eleqian/eLight/doc/867A/SCH.png

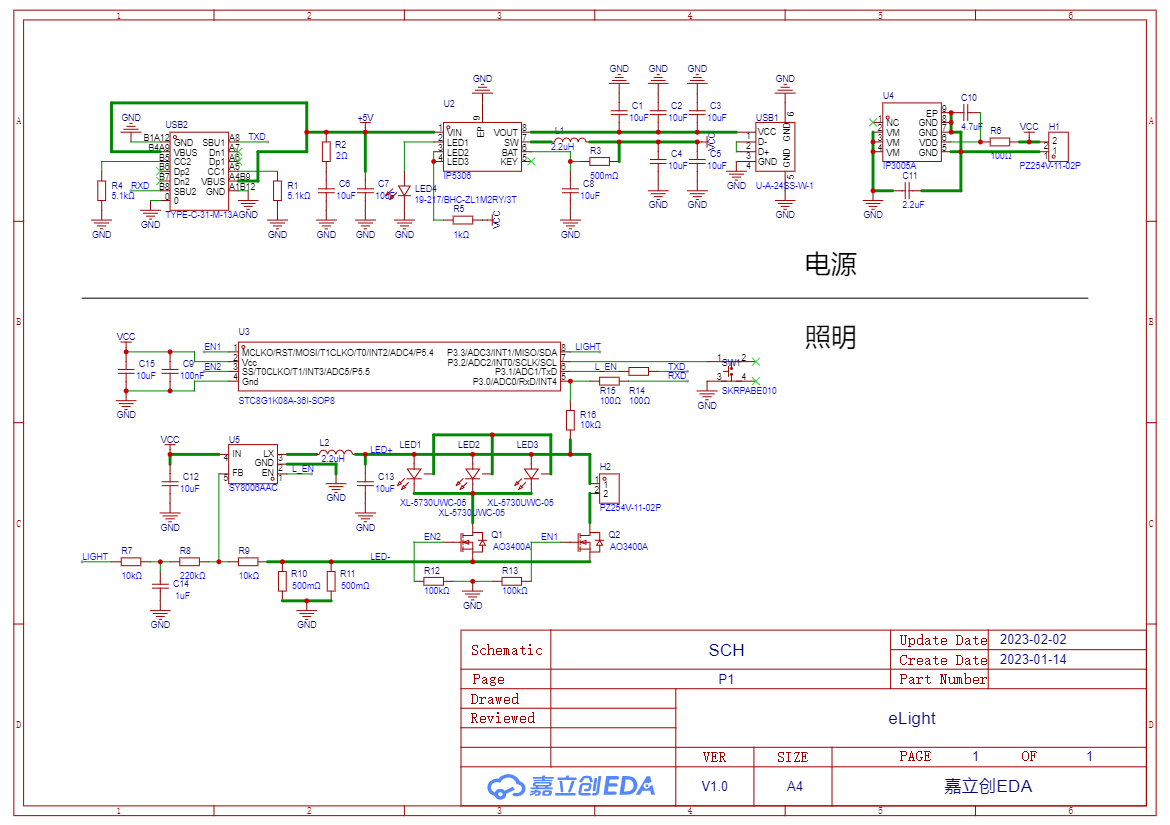
doc/867A/SCH.png
