eleqian/eLight/doc/Core/3D_PCB.png

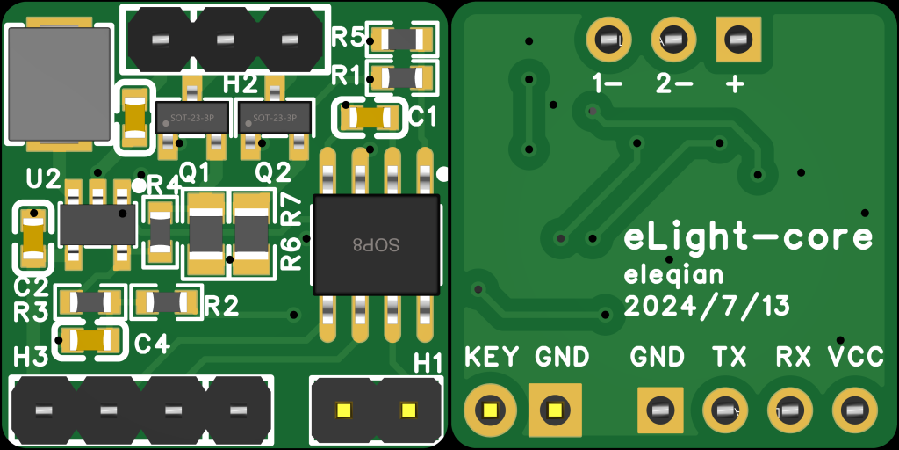
doc/Core/3D_PCB.png
