eleqian/eLight/doc/Core/3D_PCB_B.png

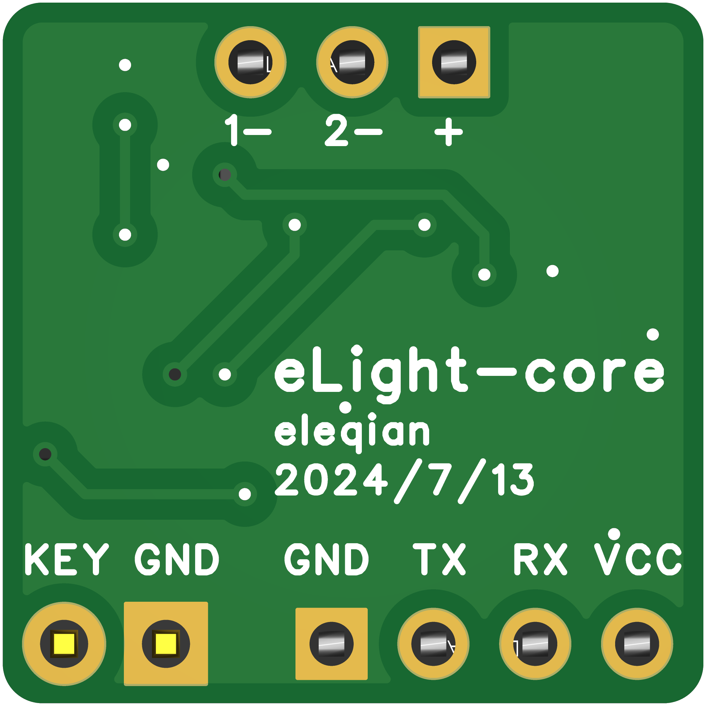
doc/Core/3D_PCB_B.png
