eleqian/eLight/doc/Core/3D_PCB_F.png

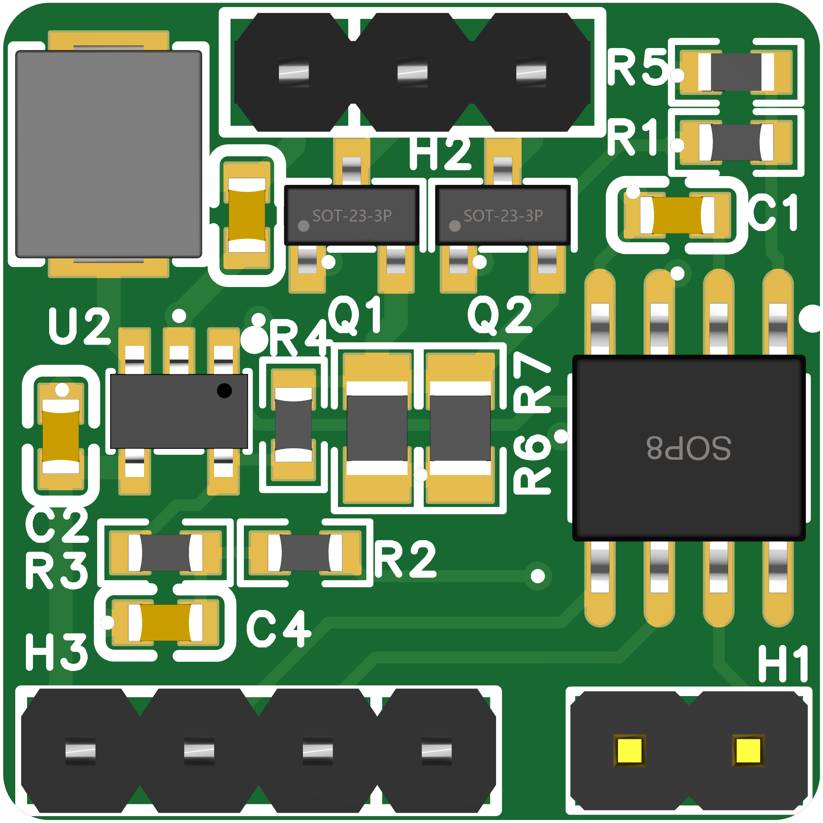
doc/Core/3D_PCB_F.png
