eleqian/eLight/doc/SD-1006/SCH.png

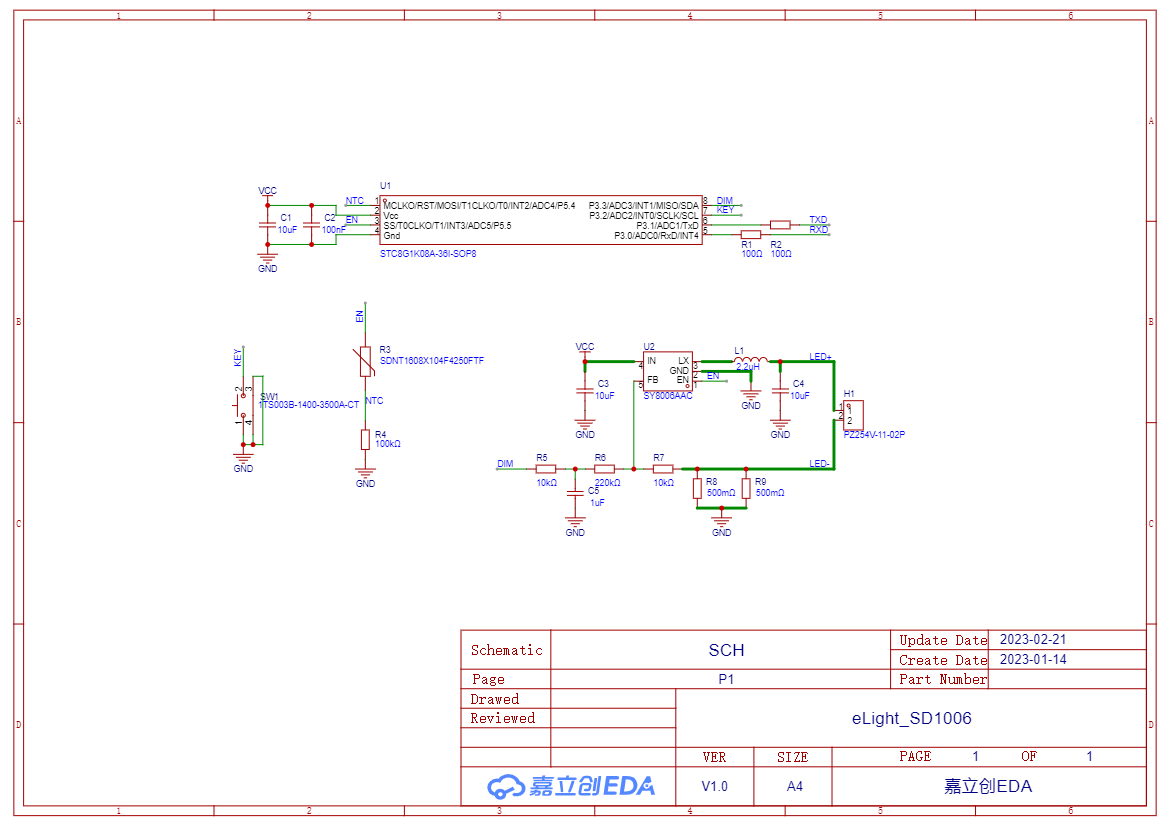
doc/SD-1006/SCH.png
