eleqian/eLight/doc/Core/eLight_Core_PCB.pdf

C1

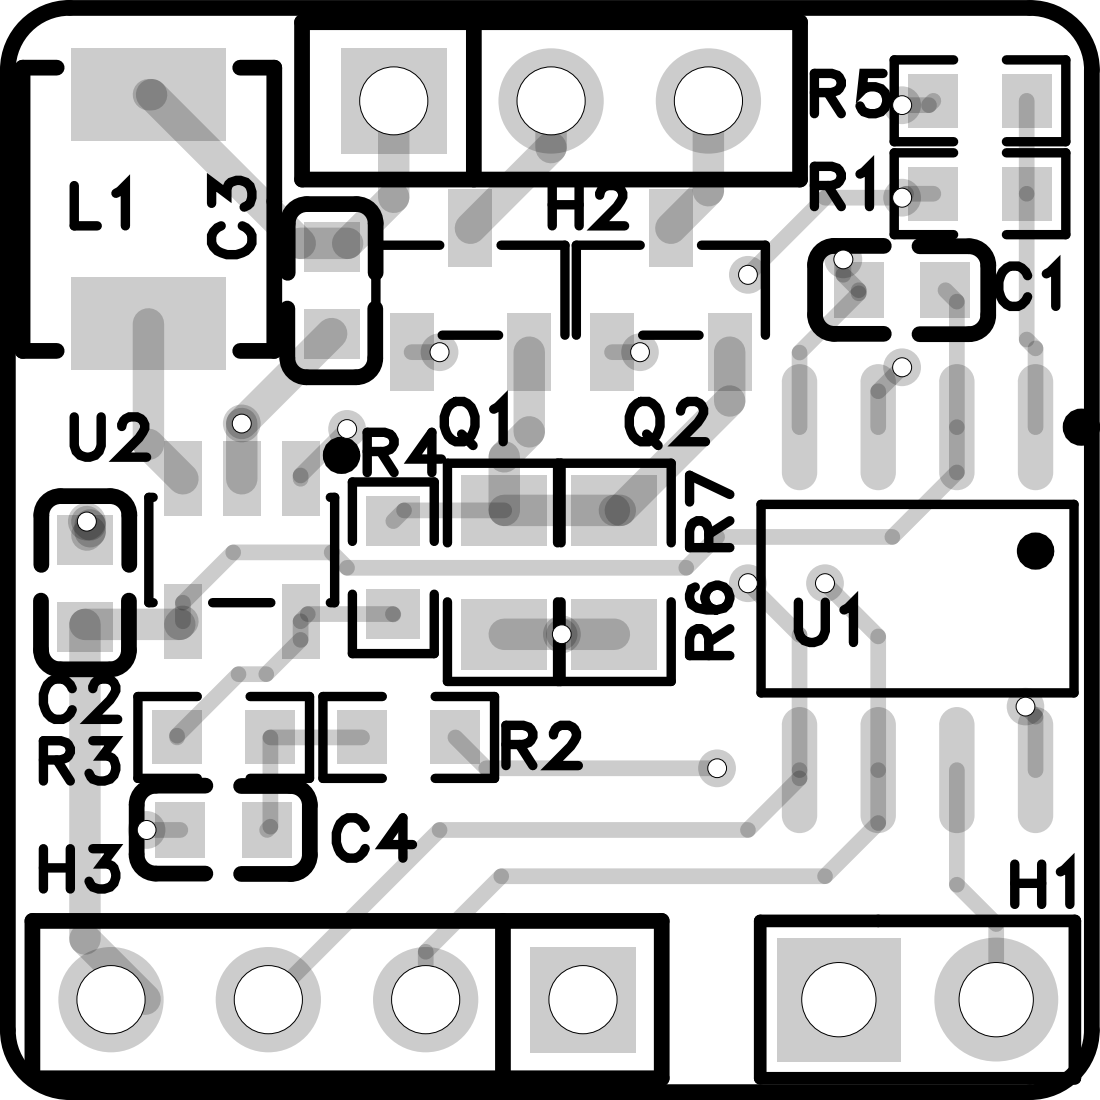
[picture p12: page 1]

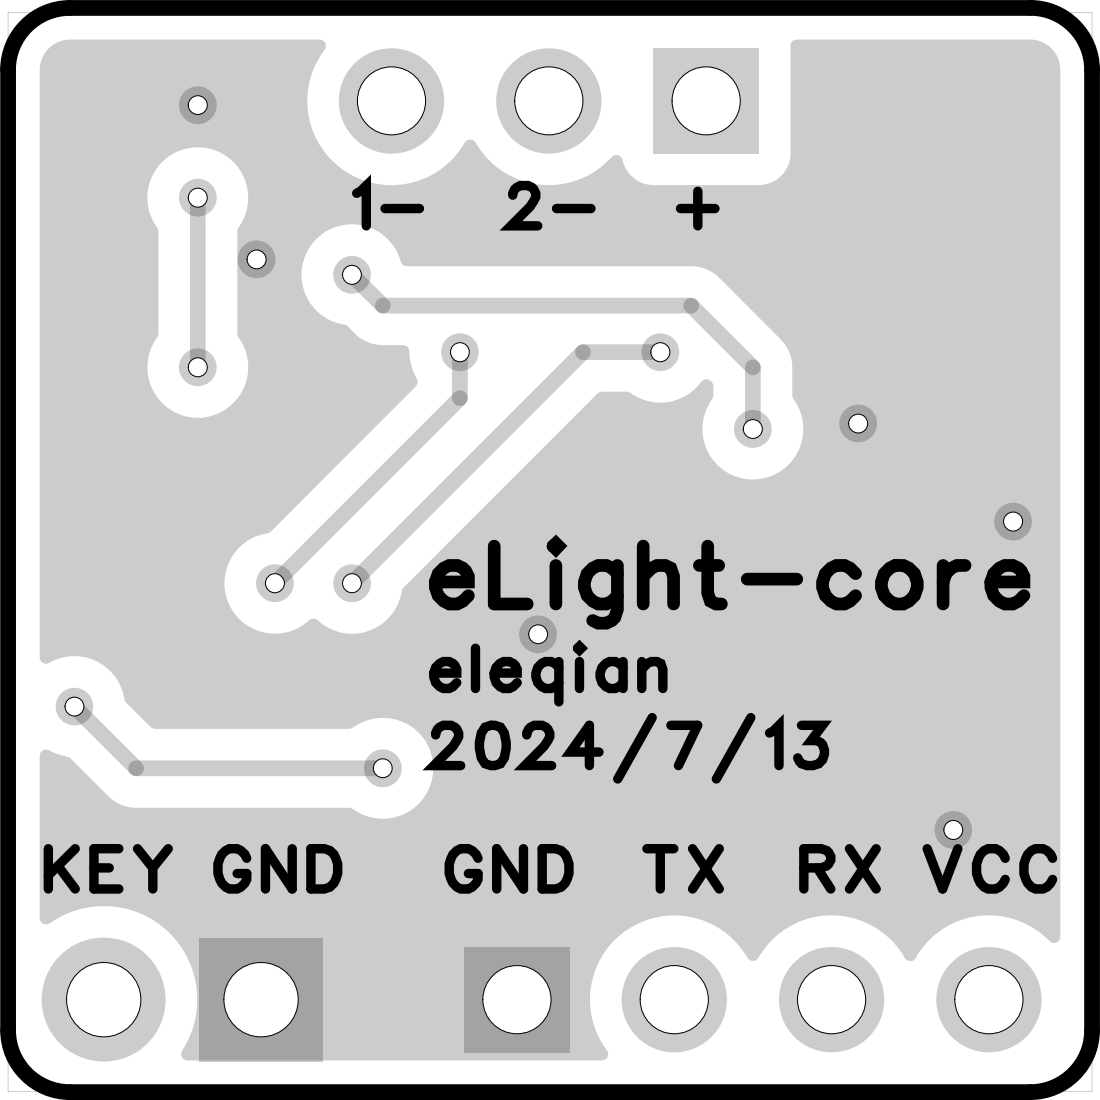
[picture p13: page 2]

KEY GND GND TX RX VCC

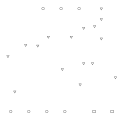
[picture p14: figure]
