eleqian/eLight/doc/Core_1W/eLight_Core_1W_SCH.pdf

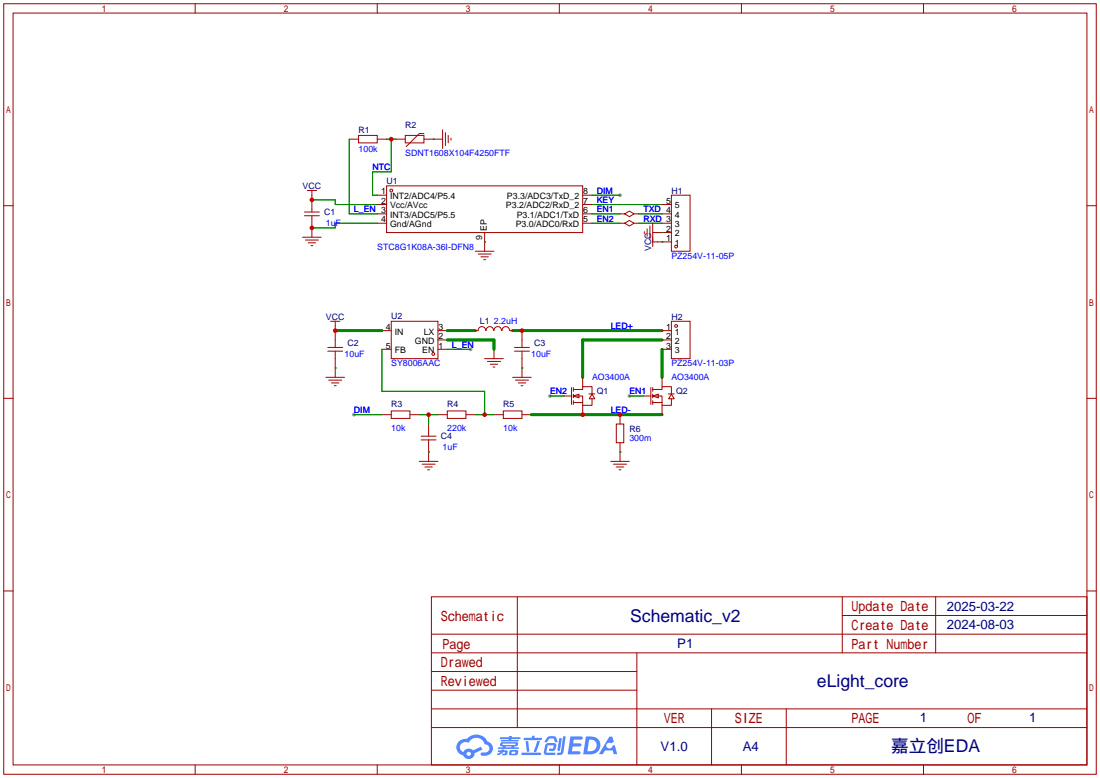
[picture p15: page 1]
