eleqian/eLight/doc/Core_5W/eLight_Core_5W_SCH.pdf

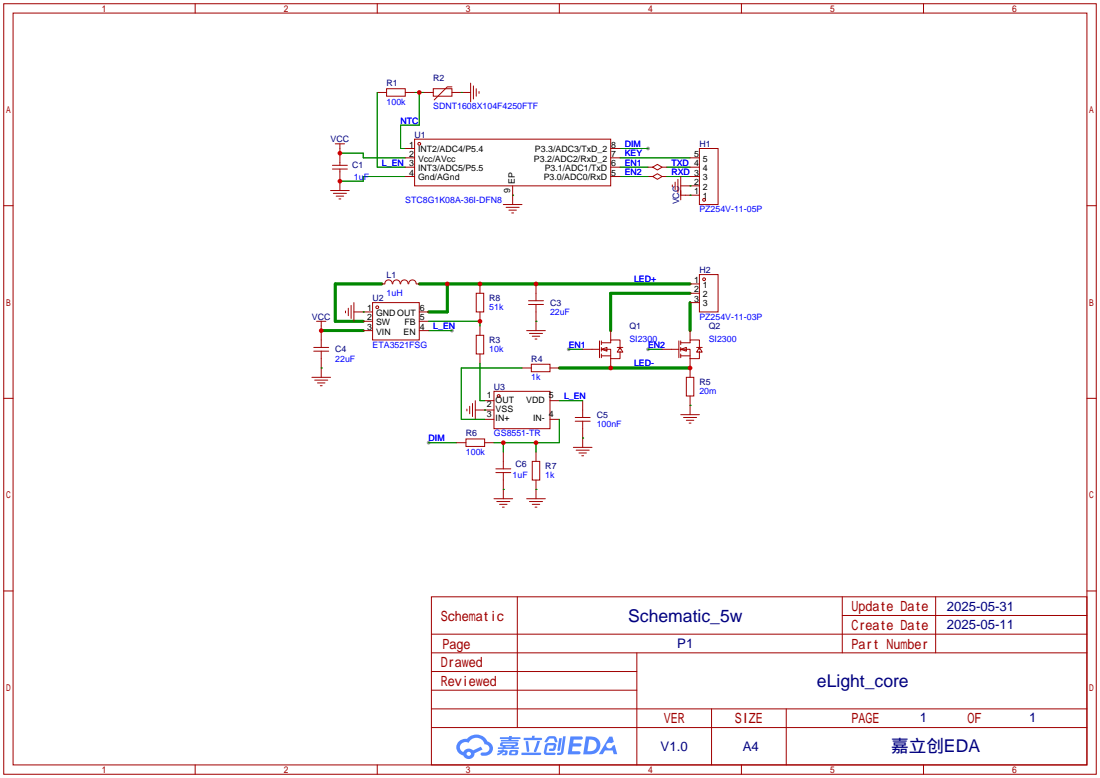
[picture p16: page 1]
