eleqian/eLight/doc/Core/eLight_Core_SCH.pdf

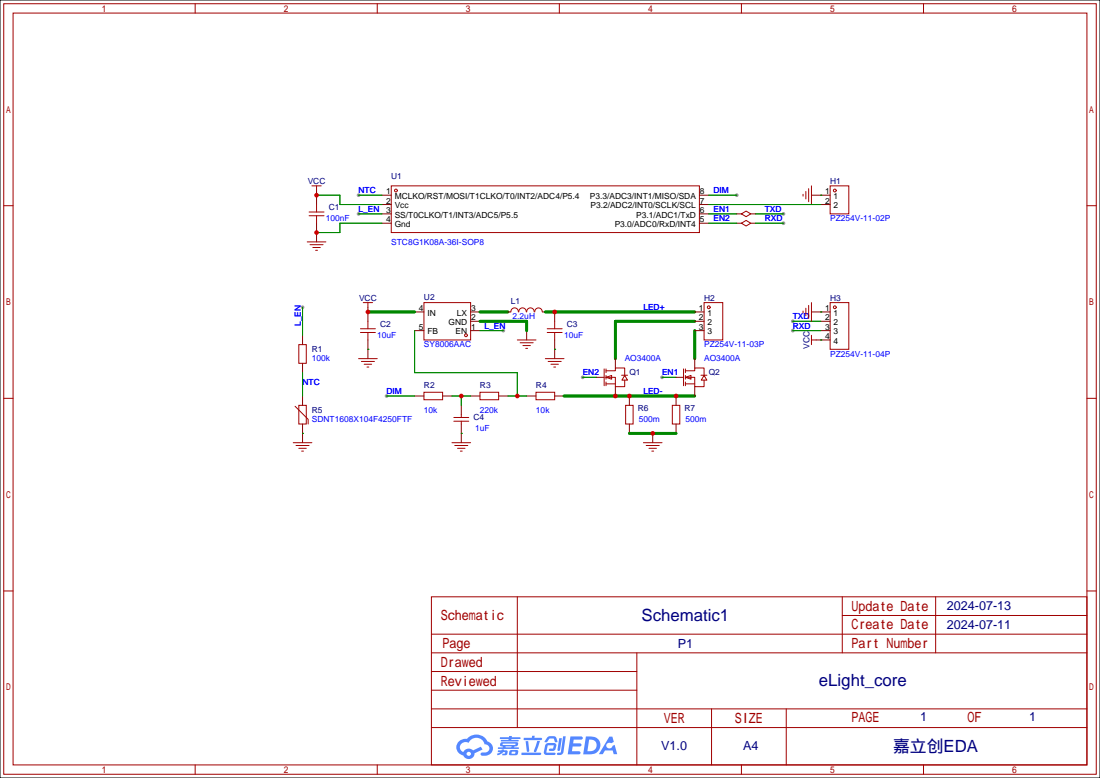
[picture p17: page 1]
