eleqian/eLight/doc/PRO_3LED/SCH.pdf

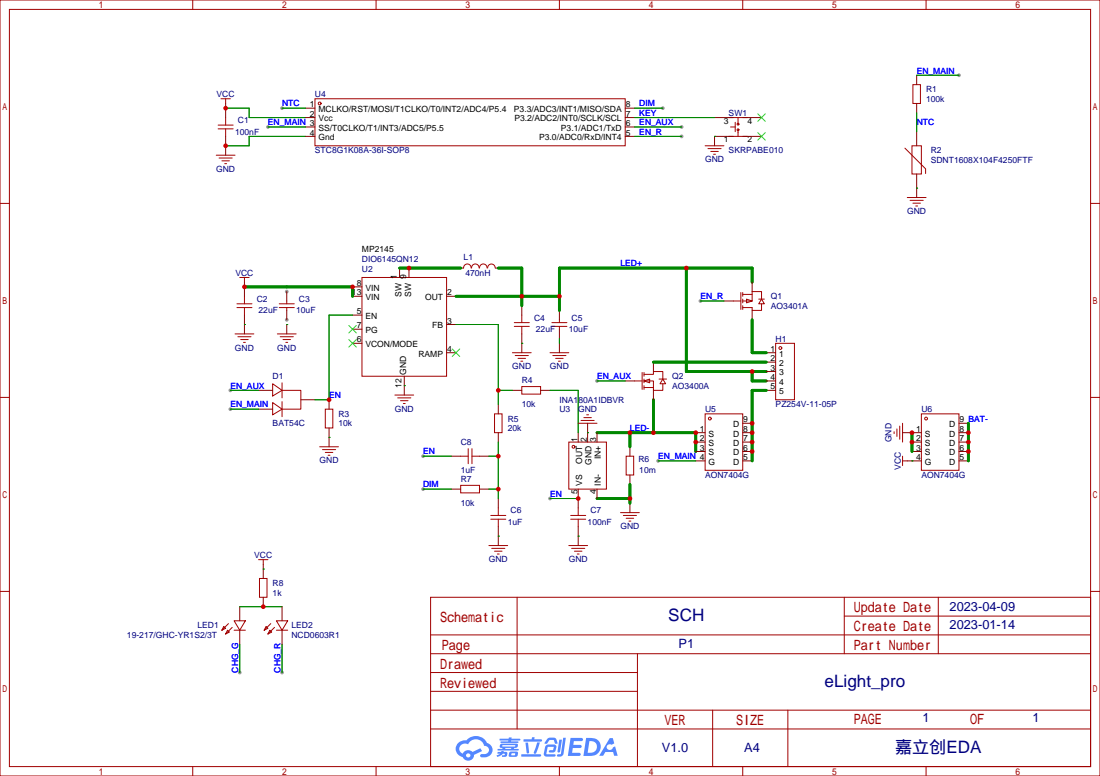
[picture p21: page 1]
