eleqian/eLight/doc/867A/eLight_PCB.pdf

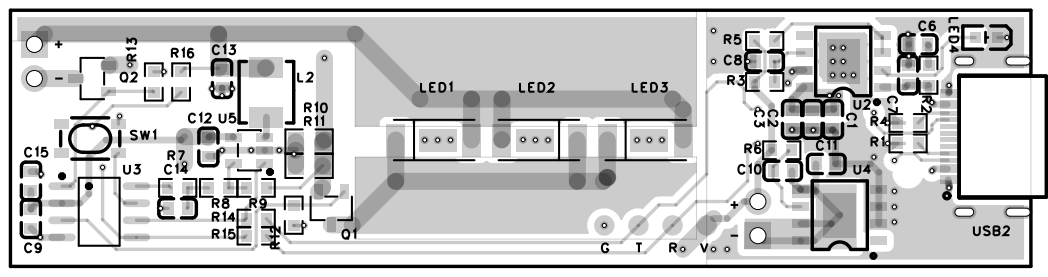
[picture p25: page 1]

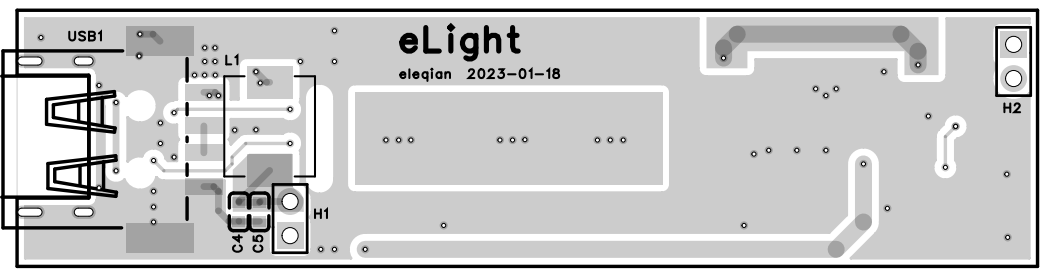
[picture p26: page 2]

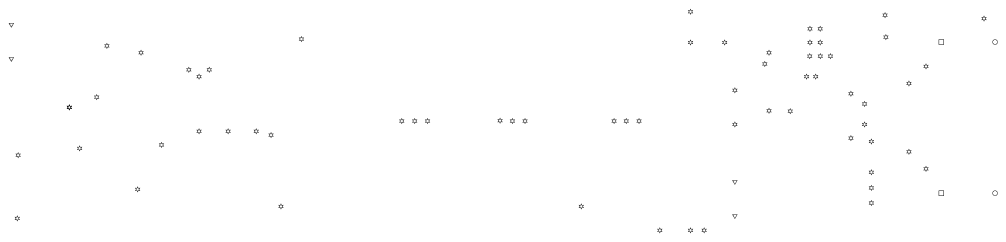
[picture p27: page 3]
