eleqian/eLight/doc/867A/eLight_SCH.pdf

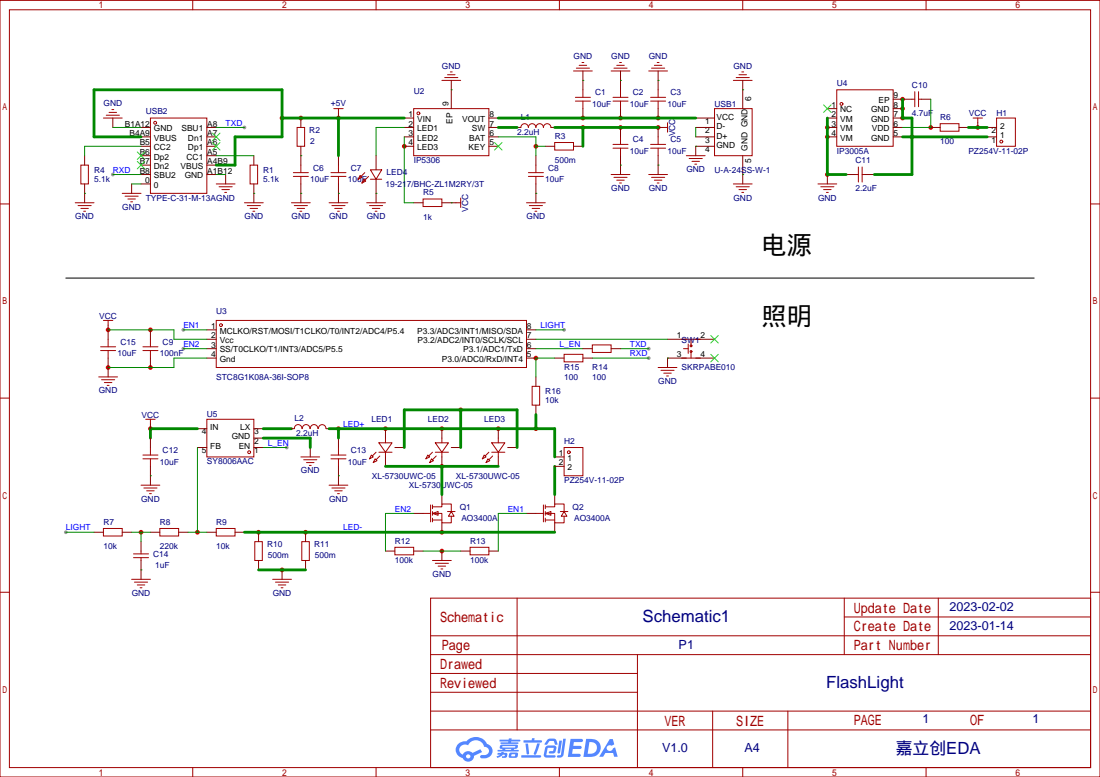
[picture p28: page 1]
