eleqian/eLight/(list of files, drawings)

Other design files:
hardware/eLight_867A.eprj
hardware/eLight_core.epro
hardware/eLight_pro.eprj
hardware/eLight_SD1006.eprj
