eleqian/eLight/software/src/light.c

#include "hal.h"
#include "key.h"
#include "ntc.h"
#include "light.h"

/* unit: 10mv */
#define LIGHT_VCC_FULL 420U /* 4.2v */
#define LIGHT_VCC_LOW 320U /* 3.2v */
#define LIGHT_VCC_EMPTY 290U /* 2.9v */
#define LIGHT_VCC_LV_TH 10 /* 0.1v */
#define LIGHT_VCC_FILTER_TH 2 /* 20mv */

#define LIGHT_VCC_FILTER_S 3

/* unit: 10ms */
#define LIGHT_T_TASK TASK_MS2TICK(10)
#define LIGHT_MS2CNT(t) ((t) / 10)
#define LIGHT_TRACK_VCC_CNT LIGHT_MS2CNT(200)
#define LIGHT_LOW_POWER_CNT LIGHT_MS2CNT(2000)
#define LIGHT_SHOW_POWER_CNT LIGHT_MS2CNT(1500)
#define LIGHT_TEMP_CHECK_CNT LIGHT_MS2CNT(2000)

typedef enum {
    LIGHT_OFF,
    LIGHT_LOCK,
    LIGHT_ON,
    LIGHT_FLASH,
    LIGHT_SOS,
    LIGHT_BAT,
    LIGHT_MODE_MAX
} light_mode_e;

typedef enum {
    POWER_NORMAL,
    POWER_LOW,
    POWER_EMPTY,
    POWER_MAX
} power_level_e;

/* 10%~100%电量对应电压，unit: 10mv */
static u16 ROM light_bat_cap[] = {368, 374, 377, 379, 382, 387, 392, 398, 406, 420};
#define LIGHT_BAT_CAP_CNT (ARRAY_SIZE(light_bat_cap))

#if CONFIG_DIM_LINEAR
/* 2%~100%驱动电流 */
static light_duty_t ROM light_level_gamma[] = {
    2, 4, 8, 12, 16, 22, 26, 30, 34, 38, 42, 46, 50, 54, 59, 64,
    70, 75, 81, 88, 95, 103, 111, 120, 130, 140, 152, 164, 177, 192, 207, 224,
    255
};
#elif CONFIG_DIM_HIGH_RES
/* 2%~100%驱动电流 */
static light_duty_t ROM light_level_gamma[] = {
    20, 23, 26, 29, 33, 37, 42, 47, 53, 60, 68, 77, 87, 99, 112, 126,
    143, 162, 183, 207, 234, 265, 299, 338, 383, 433, 489, 553, 626, 707, 800, 905,
    1023
};
#else
/* 10%~100%驱动电流 */
static light_duty_t ROM light_level_gamma[] = {
    25, 27, 29, 31, 33, 36, 38, 41, 44, 47, 51, 54, 58, 63, 67, 72, 78,
    83, 89, 96, 103, 110, 119, 127, 137, 147, 157, 169, 181, 194, 209, 224,
    240
};
#endif

#define LIGHT_LEVEL_MIN 0

/* 各种pattern定义，下标偶数(0/2/4...)为开，奇数(1/3/5...)为关 */
static u8 ROM light_flash_pattern[] = {1, 1};
#define LIGHT_FLASH_PATTERN_CNT (ARRAY_SIZE(light_flash_pattern))
static u8 ROM light_flash_scale[] = {LIGHT_MS2CNT(60), LIGHT_MS2CNT(250)};
#define LIGHT_FLASH_SCALE_CNT (ARRAY_SIZE(light_flash_scale))

static u8 ROM light_sos_pattern[] = {1, 1, 1, 1, 1, 2, 3, 2, 3, 2, 3, 2, 1, 1, 1, 1, 1, 6};
#define LIGHT_SOS_PATTERN_CNT (ARRAY_SIZE(light_sos_pattern))
static u8 ROM light_sos_scale[] = {LIGHT_MS2CNT(120), LIGHT_MS2CNT(500)};
#define LIGHT_SOS_SCALE_CNT (ARRAY_SIZE(light_sos_scale))

static u8 ROM light_low_power_pattern[] = {1, 1, 1, 1, 80};
#define LIGHT_LOW_POWER_PATTEN_CNT (ARRAY_SIZE(light_low_power_pattern))
#define LIGHT_LOW_POWER_TIME_SCALE LIGHT_MS2CNT(120)

typedef struct {
    power_level_e power_level;
    light_mode_e mode;
    led_e led;
    BOOL level_is_inc;
    u8 focus_level;
#if (CONFIG_LED_EN & CONFIG_LED_WIDE)
    u8 wide_level;
#endif
#if CONFIG_NTC_EN
    u8 temp_cnt;
#endif
    u8 flash_freq;
    u8 sos_freq;

    /* 电池电压测量 */
    u8 track_vcc_cnt;
    u16 vcc_filter;
    u16 vcc_s;

    /* 当前亮度状态 */
    u8 cur_level;
    light_duty_t cur_duty;
    light_duty_t dst_duty;
    light_duty_t duty_step;

    /* 闪烁状态管理 */
    u8 pattern_index;
    u8 pattern_num;
    u8 pattern_scale;
    u8 ROM *pattern_tbl;

    u16 wait_time;
} light_s;

static light_s light;
static tick_t light_tick;

void light_init(void)
{
    memset(&light, 0, sizeof(light));
    TASK_SET_DELAY(light_tick, 0);
    light.vcc_filter = LIGHT_VCC_FULL;
    light.vcc_s = LIGHT_VCC_FULL << LIGHT_VCC_FILTER_S;
}

static void light_update_power_level(u16 vcc)
{
    switch (light.power_level) {
        case POWER_NORMAL:
            if (vcc < LIGHT_VCC_LOW) {
                light.power_level = POWER_LOW;
            }
            break;
        case POWER_LOW:
            if (vcc < LIGHT_VCC_EMPTY) {
                if (light.cur_level > 0) {
                    /* 电量不足时自动降低亮度 */
                    light.cur_level--;
                } else {
                    light.power_level = POWER_EMPTY;
                }
            } else if (vcc > LIGHT_VCC_LOW + LIGHT_VCC_LV_TH) {
                light.power_level = POWER_NORMAL;
            }
            break;
        case POWER_EMPTY:
            if (vcc > LIGHT_VCC_LOW + LIGHT_VCC_LV_TH) {
                light.power_level = POWER_NORMAL;
            } else if (vcc > LIGHT_VCC_EMPTY + LIGHT_VCC_LV_TH) {
                light.power_level = POWER_LOW;
            }
            break;
        default:
            break;
    }
}

static light_duty_t light_level2duty(u8 level)
{
#if CONFIG_DIM_LINEAR
    /* 未根据vcc进行占空比修正，由于电流跟vcc是正比，变化范围有限 */
    light_duty_t duty = light_level_gamma[level];
#else
    u16 vcc = light.vcc_filter;
    light_duty_t duty_org = light_level_gamma[level];
    light_duty_t duty = (LIGHT_VFB * LIGHT_DIM_DIV * LIGHT_DUTY_MAX -
        LIGHT_VFB * (LIGHT_DIM_DIV - 1) * duty_org + vcc / 2) / vcc;

    if (duty > LIGHT_DUTY_MAX - 1) {
        duty = LIGHT_DUTY_MAX - 1;
    }
#endif

    return duty;
}

/* 平滑PWM占空比变化，减少亮度调整阶梯感 */
static void light_smooth_duty(void)
{
    if (light.cur_duty < light.dst_duty) {
        if (light.cur_duty + light.duty_step > light.dst_duty) {
            light.cur_duty = light.dst_duty;
        } else {
            light.cur_duty += light.duty_step;
        }
        hal_pwm_set_duty(light.cur_duty);
    } else if (light.cur_duty > light.dst_duty) {
        if (light.cur_duty < light.dst_duty + light.duty_step) {
            light.cur_duty = light.dst_duty;
        } else {
            light.cur_duty -= light.duty_step;
        }
        hal_pwm_set_duty(light.cur_duty);
    }
}

void light_set_duty(void)
{
    light_duty_t duty = light_level2duty(light.cur_level);
    u8 step;

    if (duty > light.cur_duty) {
        step = (duty - light.cur_duty) / 5;
    } else if (duty < light.cur_duty) {
        step = (light.cur_duty - duty) / 5;
    } else {
        hal_pwm_set_duty(light.cur_duty);
        return;
    }

    if (step == 0) {
        step = 1;
    }

    light.dst_duty = duty;
    light.duty_step = step;

    light_smooth_duty();
}

static void light_vcc_filter(u16 vcc)
{
    u16 vs;
    u16 vd;

    /* 滑动平均滤波，抑制大电流时内阻压降导致的闪烁 */
    light.vcc_s += vcc - (light.vcc_s >> LIGHT_VCC_FILTER_S);
    vs = light.vcc_s >> LIGHT_VCC_FILTER_S;

    /* 阈值滤波，抑制小电流时电源纹波导致的闪烁 */
    if (vs < light.vcc_filter) {
        vd = light.vcc_filter - vs;
    } else {
        vd = vs - light.vcc_filter;
    }

    if (vd >= LIGHT_VCC_FILTER_TH) {
        light.vcc_filter = vs;
    }
}

static void light_init_power_level(void)
{
    u16 vcc = hal_get_vcc();
    light.vcc_filter = vcc;
    light.vcc_s = vcc << LIGHT_VCC_FILTER_S;
    light_update_power_level(vcc);
}

static void light_track_level(void)
{
    light_vcc_filter(hal_get_vcc());
    light_set_duty();
    light_update_power_level(light.vcc_filter);
}

static void light_apply_level(u8 level)
{
    light.cur_level = level;
    light_set_duty();
    light.track_vcc_cnt = 0;
}

static u8 light_get_level_max(void)
{
    switch (light.led) {
        case LED_FOCUS:
            if (light.mode == LIGHT_FLASH) {
                return CONFIG_FOCUS_FLASH_LV_MAX;
            } else {
                return CONFIG_FOCUS_LV_MAX;
            }
#if (CONFIG_LED_EN & CONFIG_LED_WIDE)
        case LED_WIDE:
            return CONFIG_WIDE_LV_MAX;
#endif
#if (CONFIG_LED_EN & CONFIG_LED_RED)
        case LED_RED:
            return CONFIG_RED_LV_MAX;
#endif
        default:
            return 0;
    }
}

static u8 light_get_level(void)
{
#if (CONFIG_LED_EN & CONFIG_LED_WIDE)
    return (light.led == LED_FOCUS) ? light.focus_level : light.wide_level;
#else
    return light.focus_level;
#endif
}

static void light_set_level(u8 level)
{
    if (light.led == LED_FOCUS) {
        if (light.focus_level != level) {
            light.focus_level = level;
            light_apply_level(level);
        }
    } else {
#if (CONFIG_LED_EN & CONFIG_LED_WIDE)
        if (light.wide_level != level) {
            light.wide_level = level;
            light_apply_level(level);
        }
#endif
    }
}

static u8 light_vbat2cap(u16 vbat)
{
    u8 i;

    for (i = 0; i < LIGHT_BAT_CAP_CNT; i++) {
        if (vbat < light_bat_cap[i]) {
            break;
        }
    }

    return i;
}

static u8 light_vbat_time(void)
{
    u16 vcc = hal_get_vcc();
    u8 cap = light_vbat2cap(vcc);

    light_update_power_level(vcc);

    if (cap == 0) {
        return 1;
    } else {
        return cap * (LIGHT_SHOW_POWER_CNT / LIGHT_BAT_CAP_CNT);
    }
}

static void light_pattern_update(void)
{
    if (light.pattern_tbl == NULL) {
        return;
    }

    if (light.wait_time > 0) {
        light.wait_time--;
    } else {
        light.pattern_index++;
        if (light.pattern_index >= light.pattern_num) {
            light.pattern_index = 0;
        }
        light.wait_time = light.pattern_tbl[light.pattern_index] * light.pattern_scale;
        hal_led_en((light.pattern_index & 0x1) ? LED_NONE : light.led);
    }
}

static void light_set_pattern(u8 ROM *tbl, u8 num, u8 scale)
{
    light.pattern_tbl = tbl;
    light.pattern_num = num;
    light.pattern_scale = scale;
    light.pattern_index = 0;
    light.wait_time = light.pattern_tbl[0] * light.pattern_scale;
    hal_led_en(light.led);
}

static void light_disable_pattern(void)
{
    light.pattern_tbl = NULL;
}

static BOOL light_is_pattern_en(void)
{
    return (light.pattern_tbl != NULL);
}

static void light_set_mode(light_mode_e mode)
{
    light.mode = mode;
    light_disable_pattern();

    switch (mode) {
        case LIGHT_OFF:
            light.wait_time = LIGHT_LOW_POWER_CNT;
            hal_led_en(LED_NONE);
            break;
        case LIGHT_ON:
            hal_led_en(light.led);
            break;
        case LIGHT_FLASH:
            light_apply_level(light_get_level_max());
            light_set_pattern(light_flash_pattern, LIGHT_FLASH_PATTERN_CNT, light_flash_scale[light.flash_freq]);
            break;
        case LIGHT_SOS:
            light_apply_level(light_get_level_max());
            light_set_pattern(light_sos_pattern, LIGHT_SOS_PATTERN_CNT, light_sos_scale[light.sos_freq]);
            break;
        case LIGHT_BAT:
            light.led = LED_INDICATE;
            light.wait_time = light_vbat_time();
            light.cur_duty = light_level2duty(LIGHT_LEVEL_MIN);
            light_apply_level(LIGHT_LEVEL_MIN);
            hal_led_en(light.led);
            break;
        case LIGHT_LOCK:
            light.led = LED_INDICATE;
            light.wait_time = LIGHT_LOW_POWER_CNT;
            light.cur_duty = light_level2duty(LIGHT_LEVEL_MIN);
            light_apply_level(LIGHT_LEVEL_MIN);
            hal_led_en(LED_NONE);
            break;
        default:
            break;
    }
}

static void light_off_proc(key_event_e key)
{
    switch (key) {
        case KEY_EVENT_SHORT:
            light.led = LED_FOCUS;
            light_apply_level(light.focus_level);
            light_set_mode(LIGHT_ON);
            light_init_power_level(); /* 从off到on时立即刷新电量状态，可能经过了充电 */
            return;
        case KEY_EVENT_SHORT_2:
            light.level_is_inc = TRUE;
            light_set_level(light_get_level_max());
            light_set_mode(LIGHT_ON);
            return;
        case KEY_EVENT_LONG:
            light_set_mode(LIGHT_BAT);
            return;
        default:
            break;
    }

    if (light.wait_time > 0) {
        light.wait_time--;
    } else {
        light.wait_time = LIGHT_LOW_POWER_CNT;
        hal_enter_low_power();
    }
}

static void light_lock_proc(key_event_e key)
{
    hal_led_en(LED_NONE);

    switch (key) {
        case KEY_EVENT_PRESS:
            light.wait_time = LIGHT_LOW_POWER_CNT;
            hal_led_en(LED_INDICATE);
            break;
        case KEY_EVENT_SHORT_4:
            light_set_mode(LIGHT_OFF);
            return;
        default:
            break;
    }

    if (light.wait_time > 0) {
        light.wait_time--;
    } else {
        light.wait_time = LIGHT_LOW_POWER_CNT;
        hal_enter_low_power();
    }
}

static void light_adjust_direction(void)
{
    /* 每次长按或者达到边界时切换亮度调整方向 */
    u8 level = light_get_level();

    if (level == light_get_level_max()) {
        light.level_is_inc = 0;
    } else if (level == LIGHT_LEVEL_MIN) {
        light.level_is_inc = 1;
    } else {
        light.level_is_inc = !light.level_is_inc;
    }
}

static void light_adjust_level(void)
{
    u8 level = light_get_level();

    if (light.level_is_inc) {
        level = (level < light_get_level_max()) ? level + 1 : level;
    } else {
        level = (level > LIGHT_LEVEL_MIN) ? level - 1 : level;
    }
    light_set_level(level);
}

static void light_on_proc(key_event_e key)
{
    switch (key) {
        case KEY_EVENT_SHORT:
            light_set_mode(LIGHT_OFF);
            return;
        case KEY_EVENT_SHORT_2:
#if (CONFIG_LED_EN & CONFIG_LED_WIDE)
            light.led = LED_WIDE;
            light_apply_level(light.wide_level);
            light_set_mode(LIGHT_ON);
#else
            light.level_is_inc = TRUE;
            light_set_level(light_get_level_max());
#endif
            break;
        case KEY_EVENT_SHORT_3:
#if (CONFIG_LED_EN & CONFIG_LED_RED)
            if (light.led == LED_WIDE) {
                light.led = LED_RED;
            }
#endif
            light_set_mode(LIGHT_FLASH);
            return;
        case KEY_EVENT_LONG:
            light_adjust_direction();
            /* fall-through */
        case KEY_EVENT_LONG_REPEAT:
            light_adjust_level();
            break;
        default:
            break;
    }

    if (light.power_level == POWER_EMPTY) {
        light_set_mode(LIGHT_OFF);
    } else if (light.power_level == POWER_LOW) {
        if (!light_is_pattern_en()) {
            light_set_pattern(light_low_power_pattern, LIGHT_LOW_POWER_PATTEN_CNT, LIGHT_LOW_POWER_TIME_SCALE);
        }
    } else if (light_is_pattern_en()) {
        hal_led_en(light.led);
        light_disable_pattern();
    }
}

static void light_flash_proc(key_event_e key)
{
    switch (key) {
        case KEY_EVENT_SHORT:
            light_set_mode(LIGHT_SOS);
            return;
        case KEY_EVENT_SHORT_4:
            light_set_mode(LIGHT_LOCK);
            return;
        case KEY_EVENT_LONG:
            light.flash_freq = !light.flash_freq;
            light_set_pattern(light_flash_pattern, LIGHT_FLASH_PATTERN_CNT, light_flash_scale[light.flash_freq]);
            break;
        default:
            break;
    }

    if (light.power_level == POWER_EMPTY) {
        light_set_mode(LIGHT_OFF);
    }
}

static void light_sos_proc(key_event_e key)
{
    switch (key) {
        case KEY_EVENT_SHORT:
            light_set_mode(LIGHT_OFF);
            return;
        case KEY_EVENT_SHORT_2:
            light.level_is_inc = TRUE;
            light_set_level(light_get_level_max());
            light_set_mode(LIGHT_ON);
            return;
        case KEY_EVENT_LONG:
            light.sos_freq = !light.sos_freq;
            light_set_pattern(light_sos_pattern, LIGHT_SOS_PATTERN_CNT, light_sos_scale[light.sos_freq]);
            break;
        default:
            break;
    }

    if (light.power_level == POWER_EMPTY) {
        light_set_mode(LIGHT_OFF);
    }
}

static void light_bat_proc(key_event_e key)
{
    UNUSED(key);
    light.wait_time--;
    if (light.wait_time == 0) {
        light_set_mode(LIGHT_OFF);
    }
}

static void light_mode_proc(void)
{
    key_event_e key = key_get_event();

    switch (light.mode) {
        case LIGHT_OFF:
            light_off_proc(key);
            break;
        case LIGHT_LOCK:
            light_lock_proc(key);
            break;
        case LIGHT_ON:
            light_on_proc(key);
            break;
        case LIGHT_FLASH:
            light_flash_proc(key);
            break;
        case LIGHT_SOS:
            light_sos_proc(key);
            break;
        case LIGHT_BAT:
            light_bat_proc(key);
            break;
        default:
            break;
    }
}

static void light_temp_protect(void)
{
#if CONFIG_NTC_EN
    u8 temp;

    if (light.mode != LIGHT_ON) {
        light.temp_cnt = 0;
        return;
    }

    if (light.temp_cnt > 0) {
        light.temp_cnt--;
        return;
    }

    light.temp_cnt = LIGHT_TEMP_CHECK_CNT;
    temp = ntc_get_temp();
    if (temp > CONFIG_TEMP_HIGH) {
        if (light.cur_level > light_get_level_max() * 3 / 4) {
            light.cur_level--;
        }
    }
#endif
}

static void light_track_vcc(void)
{
    if (light.mode == LIGHT_OFF || light.mode == LIGHT_LOCK) {
        light.track_vcc_cnt = 0;
        return;
    }

    if (light.track_vcc_cnt > 0) {
        light.track_vcc_cnt--;
    } else {
        light.track_vcc_cnt = LIGHT_TRACK_VCC_CNT;
        light_track_level();
    }
}

void light_task(void)
{
    if (!TASK_CHECK_READY(light_tick)) {
        return;
    }
    TASK_SET_DELAY(light_tick, LIGHT_T_TASK);

    light_smooth_duty();
    light_track_vcc();
    light_temp_protect();
    light_mode_proc();
    light_pattern_update();
}
