eleqian/eLight/(commit log)

2023-02-12 初始版本
    [STC8G1K08A-8PIN.cfg, eLight.eprj, gamma.xlsx]
2023-02-12 增加硬件pdf和图片
2023-02-13 修改部分描述
2023-02-26 增加单LED硬件和NTC温控
    [eLight_867A.eprj, eLight_SD1006.eprj, ntc.xlsx]
2023-03-03 支持设置最大亮度，修复问题
    1.聚光灯和泛光灯功率可能不一样，支持分别设置最大亮度等级；
    2.优化最低和最高亮度时调光方向判断；
    3.修复off和lock状态不能超长按强制复位问题；
    4.退出lock状态后亮度保持原来亮度。
    [config.h, hal.c, light.c]
2023-04-19 支持3 LED版本硬件
    1. 聚光灯最大10W功率（爆闪和SOS模式，常亮时<6W），最小2%功率；
    2. 泛光灯支持白光和红光，常亮时白光，爆闪和SOS时红光。
    [eLight_pro.eprj, gamma.xlsx]
2024-05-26 修复bug，增加编译好的hex文件
    1. 修复编译宏错误导致非pro版本亮度异常；
    2. 增加编译好的hex文件，可以直接烧写；
    3. 增加简单编译和烧写方法说明。
    [hal.c, light.c]
2024-08-06 增加通用双LED核心板硬件，修复bug
    1. 增加core硬件类型，通用双LED核心板（聚光+泛光）；
    2. 修复在打开状态下4连击锁定后按键不亮问题；
    3. 刷新文档说明。
    [eLight_core.epro]
2025-05-31 增加5W版本硬件，优化换挡和自动降档
    1. 新增Core 5W版本硬件，原Core版本改成Core 1W，刷新文档；
    2. 插值细分挡位切换过程，亮度变化更平滑；
    3. 电量低时先降档再关闭，避免由于内阻大导致提前关闭，提醒电压从3.3V改为3.2V；
    4. 修复温度测量问题，修改最大降档到3/4；
    5. Keil工程支持批量构建所有版本。
    [eLight_core.epro]
